didux123/veilleuse-dexcom/firmware/README.md

# Firmware veilleuse — ESP8266 (Wemos D1 mini)

PlatformIO, framework Arduino. Tout le comportement est dans
[`src/main.cpp`](src/main.cpp) ; l'interface de configuration est la page
[`web/veilleuse-config.html`](web/veilleuse-config.html).

## Câblage

```
Ruban SK6812/WS2812B          Wemos D1 mini
   5V  ──────────────────────  5V
   GND ──────────────────────  G
   DIN ──────────────────────  D1 (GPIO5)
```

- 12 LED (`NUM_LEDS`), ruban 60 LED/m collé en anneau dans le boîtier.
- Optionnel mais recommandé : ~330 Ω en série sur DIN, condensateur
  470–1000 µF entre 5V et GND.
- Consommation max réelle ≈ 0,3 A (rouge pur ×12) : n'importe quel
  chargeur USB correct suffit.

## Configuration : rien à compiler

**Aucun identifiant n'est compilé dans le binaire.** Au premier démarrage (ou
si le WiFi est inconnu), la lampe émet le réseau **ouvert** `Veilleuse-XXXX` :
on s'y connecte depuis un téléphone et **la page s'ouvre toute seule**, comme
un portail WiFi d'hôtel. Un seul formulaire regroupe :

| Champ | Rôle |
|---|---|
| Réseau WiFi + mot de passe | Connexion (jusqu'à 10 réseaux mémorisés) |
| Email + mot de passe Dexcom | Compte **publieur** (app G7, partage actif) |
| Région | Europe (`shareous1`) ou US (`share2`) |
| Seuils hypo / hyper / gyrophare | mg/dL, validés `40 ≤ hypo < hyper < gyrophare ≤ 400` |
| Mode nuit : début, fin, luminosité | Horaires **HH:MM** et % (5-100) |
| Mises à jour automatiques | Activables / désactivables |

Les champs de mot de passe laissés vides ne modifient rien (pratique pour ne
changer qu'un seuil). Tout est persisté dans `/config.cfg` en flash.

**La même page reste accessible en permanence** sur le réseau local à
`http://veilleuse-xxxxxx.local/` : c'est là qu'on revient pour modifier les
réglages. L'adresse est affichée à la fin du parcours d'installation.

Pour le développement, `include/secrets.h` (copié depuis `secrets.h.example`)
permet de pré-remplir WiFi et compte Dexcom. La config du portail est toujours
prioritaire sur `secrets.h`.

## Identité unique

Chaque lampe dérive son identité de sa puce (`ESP.getChipId()`) : hostname
mDNS/OTA `veilleuse-xxxxxx`, SSID de portail `Veilleuse-XXXX`. Plusieurs lampes
cohabitent sans collision. Visible dans `GET /api/diag` ou en série au boot :

```
[id] chipid 5FB874 | hostname veilleuse-5fb874 | AP Veilleuse-B874 | fw 1.2.0
```

## Endpoints HTTP

| Endpoint | Rôle |
|---|---|
| `GET /` | La page (gzip depuis PROGMEM, ~6 Ko) |
| `GET /api/status` | `state`, `label`, `mgdl`, `trend`, `age`, `fw`, `host` |
| `GET /api/config` | Réglages courants — **jamais de mot de passe** |
| `GET /api/scan` | Réseaux vus (cache ; relance un scan en fond) |
| `POST /api/save` | Enregistre (x-www-form-urlencoded) puis redémarre |
| `POST /api/forget` | Réinitialisation : efface WiFi, compte Dexcom et réglages, puis redémarre |
| `GET /api/diag` | Heap, uptime, `lps`, WiFi, état — diagnostic |
| `GET /api/log` | Les ~1000 derniers caractères du journal |
| `GET /api/portal?on=1` | Force l'ouverture du portail (test sans couper le WiFi) |

`state` ∈ `ok|hi|hs|lo|un|su|bo|er`, calqué sur les états LED.
Les sondes de détection captive (`/generate_204`, `/hotspot-detect.html`,
`/ncsi.txt`…) renvoient un 302 vers l'IP du point d'accès quand le portail est
ouvert : c'est ce qui déclenche l'ouverture automatique de la page.

## Flasher

```bash
pio run -t upload                                                      # USB
pio run -e d1_mini_ota -t upload --upload-port veilleuse-xxxxxx.local    # WiFi
```

Le port série est auto-détecté ; l'OTA accepte aussi une adresse IP. Pendant un
flash, l'anneau affiche une barre bleue. **Une fenêtre OTA de 3 s est garantie à
chaque démarrage**, avant l'initialisation du serveur web : si un firmware
défectueux est publié, il reste ce créneau pour reflasher sans démonter la lampe.

## La page web

`web/veilleuse-config.html` est la source éditable (17 Ko). Avant chaque
compilation, `tools/gen_web.py` (pre-script PlatformIO) la gzippe et génère
`include/web_page.h` (~6 Ko en PROGMEM, non versionné). Éditer la page suffit,
le build s'occupe du reste.

Pour itérer sur le design sans flasher : servir la page depuis un petit serveur
local qui renvoie des JSON figés sur les 4 endpoints.

## Mises à jour automatiques

Chaque lampe consulte les [GitHub Releases](https://github.com/didux123/veilleuse-dexcom/releases)
du projet et s'installe la nouvelle version toute seule :

- **Quand** : dès le premier relevé réussi après le démarrage — et si la
  vérification est reportée (page consultée, alerte en cours, RAM basse) elle
  est retentée à chaque relevé suivant. En pratique une lampe récupère une
  nouvelle version **une à deux minutes après son démarrage** (mesuré). Le
  rendez-vous quotidien vers 4 h (minute = `chipid % 60`, ce qui étale les
  téléchargements d'un parc) ne sert donc qu'aux lampes allumées depuis
  longtemps.
- **Quoi** : n'installe que des versions **strictement plus récentes**
  (comparaison sémantique `X.Y.Z`). ⚠️ Une simple inégalité serait tentante
  pour permettre les retours en arrière, mais elle **rétrograde** toute lampe
  portant un firmware plus récent que la release publiée — mesuré en vrai :
  une lampe en 1.2.0 s'est réinstallé la 1.1.0 publiée, perdant son serveur
  web. Pour revenir en arrière, **republier l'ancien code sous un numéro plus
  haut**.
- **Garde-fous** : désactivable depuis la page ; jamais pendant une hypo ou un
  gyrophare ; jamais si quelqu'un consulte la page (moins de 60 s) ou est
  connecté au portail ; pas si la RAM libre est insuffisante ; une version qui
  échoue est retentée 3 fois au maximum (suivi dans `/update.txt`).

Chaque lampe publie aussi sa version en mDNS :
`dns-sd -L veilleuse-xxxxxx _arduino._tcp local` affiche `fw=1.2.0`.

⚙️ Détail à connaître : `objects.githubusercontent.com` n'annonce pas de
`max_fragment_length` et envoie des enregistrements TLS pleine taille. Le
téléchargement du binaire renvoie **zéro octet** avec un buffer de réception de
1 ou 4 Ko — il faut **16 Ko** (`TLS_RX_BULK`). `version.txt` se contente de 4 Ko.

⚠️ L'ESP8266 n'a pas de partition de secours : un firmware qui ne démarre pas
oblige à un reflash de chaque lampe. D'où l'étape canari du script de release.

## Publier une version
### ⚠️ Les binaires publiés ne doivent contenir aucun identifiant

`include/secrets.h` est compilé **dans** le firmware. Un `firmware.bin` publié
sur un dépôt public est téléchargeable par tout le monde et `strings` suffit à
en extraire l'email, le mot de passe Dexcom et les identifiants WiFi.

`scripts/release.sh` met donc le `secrets.h` du poste de dev de côté, compile
avec des valeurs vides, **vérifie que le binaire ne contient aucune de vos
valeurs** (sinon il refuse de publier) et le restaure ensuite. Ne jamais
publier un binaire compilé à la main sans cette vérification :

```bash
strings firmware/.pio/build/d1_mini/firmware.bin | grep -i votre-email
```

```bash
./scripts/release.sh
```

Le script refuse un arbre git sale, un HEAD non poussé ou un tag existant ;
il compile, génère `version.txt`, **impose de valider la version sur sa propre
lampe** (canari) puis publie la release. Incrémenter `FW_VERSION` dans
`main.cpp` avant de le lancer.

Pour tester la chaîne d'auto-update sans exposer le parc : publier une
**prerelease** (invisible de `latest`) et flasher une lampe de test avec
l'environnement `d1_mini_testupd`.

## Vérification des identifiants Dexcom

Une faute de frappe dans le mot de passe Dexcom doit se voir **tout de suite**,
pas après un redémarrage. Deux situations :

- **La lampe a déjà du réseau** (page de réglages) : `POST /api/save` teste le
  couple email/mot de passe auprès de Dexcom *avant* d'enregistrer (~1,5 s) et
  répond `400 {"err":"dexcom"}` en cas de refus. Rien n'est écrit, rien ne
  redémarre, la page ramène l'utilisateur sur l'écran du compte.
- **Première configuration par le portail captif** : la lampe n'a aucun accès
  Internet, elle ne peut rien vérifier. Elle **n'redémarre donc pas** — un
  reboot ferait disparaître son réseau 15 s, le téléphone partirait voir
  ailleurs et l'utilisateur n'apprendrait jamais son erreur. À la place elle
  répond `{"ok":true,"pending":true}`, garde son point d'accès et se connecte
  au WiFi à chaud ; la page interroge `/api/status` toutes les 3 s et affiche
  le verdict réel (`wifi` et `pending` sont là pour ça) : « Connexion au
  WiFi… », « Réseau introuvable ou mot de passe incorrect », « Identifiants
  Dexcom refusés », ou la glycémie. Ce n'est qu'une fois la réussite constatée
  que la lampe redémarre, 10 s plus tard — le temps de laisser lire l'adresse.

Un seul essai d'authentification par action humaine, dans tous les cas : la
règle anti-verrouillage du compte Dexcom n'est pas assouplie. Et si les
identifiants n'ont pas changé, aucune vérification n'est envoyée.

## Emmener la lampe ailleurs (portail sans réseau connu)

Cas réel : une lampe configurée à la maison, emmenée chez quelqu'un d'autre.
Le réseau habituel est absent, la lampe passe bien en violet — mais **son
point d'accès restait introuvable**, donc impossible de la reconfigurer.

Cause : l'ESP8266 n'a **qu'une seule radio**. Avec `setAutoReconnect(true)` et
des identifiants mémorisés, la station cherche son réseau habituel en
permanence, en balayant les canaux ; pendant ce temps le point d'accès
n'émet plus ses balises et n'apparaît dans aucun téléphone.

Correctif : quand le portail s'ouvre **faute de réseau**, la radio lui est
**dédiée** — `setAutoReconnect(false)`, `WiFi.disconnect(false, false)` puis
`WiFi.mode(WIFI_AP)`, sur un canal fixe (le canal du lieu précédent n'a plus
de sens). ⚠️ La surcharge à un seul argument `WiFi.disconnect(false)` **efface
les identifiants mémorisés** : il faut impérativement la forme à deux
arguments.

Comme la lampe ne cherche alors plus rien, `staRetryTick()` lui ménage une
**fenêtre de recherche de 15 s toutes les 3 minutes**, jamais pendant que
quelqu'un est connecté au portail. Le scan y est **asynchrone** puis suivi
d'un `WiFi.begin()` ciblé : rien ne fige, contrairement à `wifiMulti.run()`.
Un scan réactive toujours la station (le SDK force `enableSTA`) — `pollScan()`
la recoupe donc aussitôt en radio dédiée.

Quand la lampe a du réseau (identifiants Dexcom à corriger), le portail garde
au contraire la station : la page reste jointe sur le réseau local.

Mesuré après correctif, avec un réseau connu mais absent : point d'accès
visible sur **12 relevés consécutifs en 4 min 40**, toujours sur son canal,
fenêtres de recherche comprises.

## Porte de secours : trois coupures

**Débrancher et rebrancher trois fois de suite** (moins de 8 s entre chaque)
force l'ouverture du portail pendant 10 minutes, quel que soit l'état de la
lampe. C'est le dernier recours quand elle est chez quelqu'un d'autre et
refuse de se montrer. Le compteur est dans `/boot.cnt` et se remet à zéro dès
que la lampe tourne plus de 8 secondes : un redémarrage isolé ne déclenche
rien.

## Réinitialisation

Le bouton « Réinitialiser la lampe… » de la page (section Maintenance) demande
une **seconde confirmation** avant d'agir, puis appelle `POST /api/forget` :
`/wifis.txt` et `/update.txt` sont supprimés, une configuration **vide** est
écrite (et non pas le fichier supprimé — son absence ferait retomber sur les
identifiants de `secrets.h`), et le réseau mémorisé par le SDK est oublié juste
avant le redémarrage. La lampe repart en portail, comme sortie de boîte.

L'endpoint n'accepte que `POST` : on ne peut pas effacer une lampe en cliquant
sur un lien. Et la réponse `200` est envoyée **avant** de toucher au WiFi —
couper la STA plus tôt empêcherait la réponse d'arriver et la page annoncerait
un échec alors que l'effacement a réussi.

⚠️ Sur un build de développement, `secrets.h` réintroduit son WiFi au
redémarrage (le seed) : la lampe se reconnecte donc au réseau, mais sans
identifiants Dexcom. Sur un binaire de production (secrets vides) l'oubli est
total.

## Fichiers en flash (LittleFS)

| Fichier | Contenu |
|---|---|
| `/wifis.txt` | Réseaux connus, `ssid<TAB>motdepasse`, plus récent en tête |
| `/config.cfg` | `ver=2`, identifiants, région, seuils, mode nuit (minutes), `ota` |
| `/update.txt` | Dernière version tentée + nombre d'essais (anti-boucle) |

Le format v1 (horaires de nuit en heures entières) est migré automatiquement
vers v2 (minutes) au premier démarrage.

## États lumineux

Voir le [README principal](../README.md#code-couleur). Logique dans
`currentState()` + `render()` : priorité aux erreurs (jamais de faux vert),
hypo à pleine puissance même en mode nuit. `DEMO_MODE 1` en tête de
`main.cpp` fait défiler tous les états (6 s chacun) sans appeler Dexcom.

**Violet/rouge alterné** : identifiants Dexcom refusés ou absents. La lampe
ouvre son portail pour permettre la correction sans reflash, et n'envoie plus
aucune requête à Dexcom tant que de nouveaux identifiants n'ont pas été
enregistrés : une action humaine = un essai (protège le compte d'un
verrouillage).

## Anti-verrouillage Dexcom

Le compte peut être bloqué par des authentifications en rafale. Le firmware
garde `accountId` et la session en RAM, re-login **une seule fois** sur session
expirée, backoff exponentiel 60 s → 5 min sur erreur réseau, et arrêt complet
des requêtes sur identifiants refusés. Ne pas « améliorer » ça avec des
retries agressifs.

## Ordonnancement (à ne pas casser)

`server.handleClient()` et `dns.processNextRequest()` sont **en tête de
`loop()`**. Les opérations bloquantes restantes sont encadrées de garde-fous :
requête TLS Dexcom (2-6 s, différée si quelqu'un consulte la page ou si un scan
tourne), `wifiMulti.run()` (≤ 8 s, jamais si un client est sur le portail),
téléchargement d'une mise à jour (30-60 s, serveur et AP fermés le temps du
flash). Le scan WiFi est **asynchrone** — un scan synchrone appelle
`esp_suspend()` et figerait la boucle, donc les LED et le serveur web.
`GET /api/diag` expose `lps` (itérations de `loop()` par seconde, ~12 000 en
régime normal) : une chute signale un gel.
