didux123/veilleuse-dexcom/landing/design-source/Halo - Landing.dc.html

Veilleuse connectée · Dexcom G6 / G7

# Sa glycémie, en lumière, toute la nuit.

Halo est un galet lumineux posé sur la table de nuit. Il change de couleur et de rythme au fil de la nuit, et c'est tout. Pas d'écran, pas de chiffre, pas de notification à décoder à 3 h du matin.

Précommander Halo Voir la démo

Pensé pour

Les parents d'enfants T1 La chambre d'à côté, sans y entrer.

Les conjoints qui dorment mal Un œil ouvert suffit, le téléphone reste posé.

Les colocs, les grands-parents, les internats Rien à installer, rien à apprendre.

La démo · huit états

## Appuie, et regarde la chambre changer.

Quatre couleurs pour la nuit, quatre pour la mise en route. Chaque état a son rythme : c'est le mouvement qui se remarque, pas la teinte.

BasDans la plage Haut Très haut Sans données Configuration Identifiants refusés Démarrage

{{ demoTitle }}

{{ demoMeta }}

{{ demoText }}

Comment ça marche

## Trois minutes, une main, aucune application.

1

Elle respire en violet

Branche-la : elle ouvre son propre réseau WiFi. Tu t'y connectes, une page s'affiche toute seule.

2

Tu donnes le WiFi et le compte Share

Les identifiants Dexcom Share du porteur, tes seuils, ta plage de nuit. Tout reste dans la lampe.

3

Elle veille

Elle lit la valeur toutes les 60 secondes et se contente d'exister. Plus rien à faire jusqu'à la prochaine panne de courant.

Mode nuit

### 22 % de luminosité entre 22 h et 7 h

Assez pour lire la couleur depuis le lit, pas assez pour éclairer la pièce. Une seule exception, jamais négociable : l'hypo passe à pleine puissance.

Vie privée

### Aucun serveur, aucun compte à créer

La lampe parle directement à Dexcom Share. Nous n'avons pas de cloud, pas de base de données, rien à revendre — il n'y a personne entre elle et toi.

Ce que Halo ne fait pas

· aucune courbe, aucun graphique, aucun chiffre · aucune notification sur ton téléphone · aucun historique, aucune statistique · aucune décision à ta place

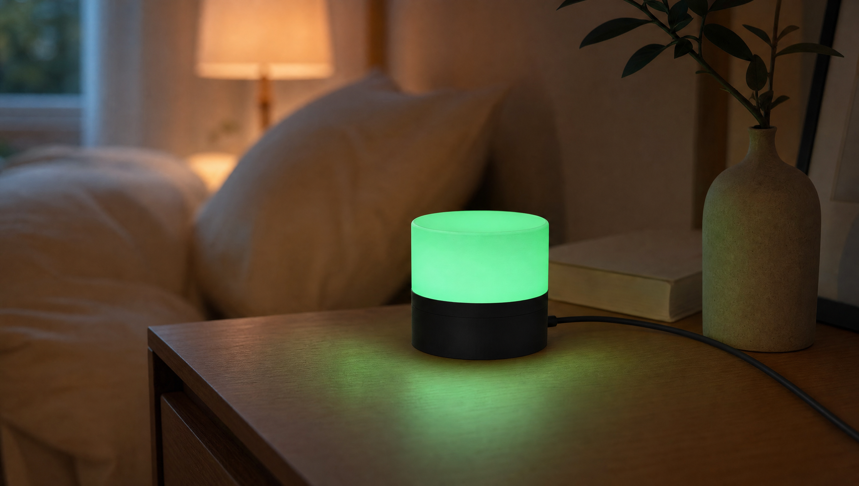
[picture p2: landing/design-source/hero-shot-ms7axl28-aewl.png]
hero-shot


Pourquoi une lampe

« Je me réveillais six fois par nuit pour attraper mon téléphone, déverrouiller, lire un chiffre. Maintenant j'ouvre un œil. »

Le besoin de départ — un objet-compagnon, pas un moniteur de santé.

L'objet

## Un galet de 80 mm, et rien d'autre à installer.

Corps noir mat, dôme blanc translucide, un seul câble qui part vers l'arrière. Elle arrive prête : tu la branches, tu donnes le WiFi, elle veille.

Dans la boîte

· la veilleuse Halo

· alimentation USB-C

· câble tressé 2 m

· guide de mise en route, 1 page

aucune application à installer

Fabriquée en petite série

Coques imprimées et assemblées à l'unité en France. Chaque lampe est testée une nuit entière avant d'être expédiée.

Garantie 2 ans, mises à jour à vie

Active les mises à jour automatiques à la configuration : le firmware se met à jour tout seul, sans rien te demander. Une pièce casse, on te la remplace.

Est-ce un dispositif médical ?

Non. Halo est un objet lumineux de confort. Aucune décision de traitement ne doit être prise à partir de sa couleur — le lecteur et l'app officielle restent la référence.

Et si le WiFi tombe ?

La lampe passe au blanc au bout de quelques minutes sans données fraîches. Elle ne prétend jamais que tout va bien.

Ça marche avec quels capteurs ?

Dexcom G6 et G7 via Share, comptes Europe et US. Un porteur, une lampe — ou plusieurs lampes pour le même porteur.

Je peux changer les seuils ?

Oui, hypo / hyper / gyrophare se règlent au chiffre exact depuis la page de configuration, en mg/dL comme en mmol/L.

Combien consomme-t-elle ?

Moins de 1 W en veille verte nocturne. Elle reste branchée en permanence, comme une veilleuse classique.

## Rends-lui ses nuits.

Première série limitée, livrée configurée. Expédition sous 15 jours.

Précommander Halo Poser une question

halo Halo n'est pas un dispositif médical et n'est affilié ni à Dexcom ni à aucun fabricant de capteurs. En cas de doute, réfère-toi toujours à ton lecteur.
