didux123/veilleuse-dexcom/landing/design-source/Veilleuse Dexcom - DA.dc.html

Direction artistique · v1 / objet + page embarquée

# Une veilleuse qui dit la glycémie en couleur, pas en chiffres.

Cylindre Ø80 × 72 mm, PLA noir mat + dôme blanc translucide, 12 LED RGB, ESP8266. Un galet posé sur une table de nuit — objet‑compagnon, pas moniteur de santé. Cette page pose la DA : les 8 états lumineux, les tokens, le kit, la page de config et une piste vitrine.

1 fichier HTML ~20 Ko en PROGMEM 0 requête externe mobile · nuit d'abord

## 01 — Les huit états

Le SVG est unique ; seules la couleur et le mouvement changent.

Pourquoi : la gravité passe par le mouvement autant que par la teinte — fixe = calme, respiration = attente, rotation = alerte, pulsation = urgence. Un dormeur à moitié réveillé lit un rythme avant de lire une couleur.

Dans la plage

LED 0,36,5 · fixe · écran #45E07F

Tout va bien. Lumière immobile : rien à faire, rien à regarder.

Hyper > 180

LED 66,18,0 · fixe · écran #FFA23A

À surveiller. Même immobilité que le vert : on informe, on ne réveille pas.

Hyper sévère > 300

LED 140,38,0 · bloc de 6 qui tourne · 1,6 s

Gyrophare. On ajoute du mouvement, pas de la lumière : la chambre ne s'éclaire pas davantage.

HYPO < 70

LED 255,0,0 · pulsation 0→255 en 1,2 s · pleine puissance

Urgence. Le dôme rond ne change pas — ce sont les coussins qui disparaissent : contraste au maximum, halo hors cadre, label en bloc plein, angles nets.

On ne sait pas

LED 30,30,30 · fixe · données périmées / réseau coupé

Blanc, jamais vert. Un silence ne doit pas ressembler à un « tout va bien ».

Mode configuration

LED 6,0,9 → 44,0,56 · respiration 3 s

L'objet attend. Le violet est hors du langage glycémie : impossible de le confondre avec une mesure.

Identifiants refusés

violet ⇄ rouge · 600 ms · sans fondu

Erreur à corriger au portail. Alternance dure, jamais de fondu : c'est une panne, pas une mesure.

Démarrage / mise à jour

LED 0,0,28 · point qui tourne, puis barre

Progression. Le bleu n'existe nulle part ailleurs : c'est la couleur de la machine, pas du corps.

La bascule cartoon → alerte, sans changer d'univers

Le vocabulaire reste identique — même galet, mêmes contours épais, mêmes rondeurs. Ce qui change en hypo, ce sont les amortisseurs : le halo diffus devient une pulsation qui sort du cadre, le contraste passe de doux à maximal, l'étiquette abandonne la pastille discrète pour un bloc plein rouge, et le rythme de 1,2 s est deux fois plus rapide que tout le reste de la DA. Résultat : rien de « mignon » n'adoucit le signal, et pourtant on est toujours dans le même monde graphique.

## 02 — Tokens

Teintes dérivées des RGB réels des LED, remontées en luminosité écran.

Pourquoi : la teinte est la source de vérité, la luminosité est un problème de média. On garde le hue du firmware et on remonte L et C pour rester lisible et accessible sur écran.

--v-ok

#45E07F
← 0,36,5

--v-high

#FFA23A
← 66,18,0

--v-high-sev

#FF6B1F
← 140,38,0

--v-low

#FF1F33
← 255,0,0

--v-unknown

#F4F1EA
← 30,30,30

--v-setup

#B96BFF
← 44,0,56

--v-boot

#4C8CFF
← 0,0,28

surfaces

900 → 600
+ --v-line

:root{
/* états — hue du firmware, L/C écran */
--v-ok:#45E07F; --v-high:#FFA23A;
--v-high-sev:#FF6B1F; --v-low:#FF1F33;
--v-unknown:#F4F1EA; --v-setup:#B96BFF;
--v-boot:#4C8CFF;
/* surfaces & encre */
--v-900:#0B0C10; --v-800:#14161D;
--v-700:#1F232D; --v-600:#2A2F3B;
--v-line:#2A2F3B; --v-stroke:#07080B;
--v-ink:#EDEAE3; --v-ink-2:#B9BFCC;
--v-ink-3:#6F7788;
/* type — stack système, 0 Ko */
--v-sans:system-ui,-apple-system,
  "Segoe UI",Roboto,Helvetica,sans-serif;
--v-mono:ui-monospace,SFMono-Regular,
  Menlo,Consolas,monospace;
--t-xs:12px; --t-sm:14px; --t-md:16px;
--t-lg:19px; --t-xl:26px; --t-2xl:34px;
/* rayons — pleins, jamais pointus */
--r-sm:10px; --r-md:16px;
--r-lg:22px; --r-pill:999px;
/* ombres colorées, jamais grises */
--sh-soft:0 14px 30px -18px
  color-mix(in oklab,var(--v-ok) 60%,#000);
--sh-alert:0 18px 40px -16px
  color-mix(in oklab,var(--v-low) 70%,#000);
/* durées = sémantique */
--d-tap:140ms; --d-calm:240ms;
--d-breathe:3s; --d-spin:1.6s;
--d-urgent:1.2s; --d-reject:600ms;
--e-pop:cubic-bezier(.34,1.56,.64,1);
--e-calm:cubic-bezier(.4,0,.2,1);
}

Échelle typo · stack système

Titre 34 / 800

Sous‑titre 26 / 700

Libellé de champ 19 / 600

Corps 16 / 400 — la taille minimale d'un champ tapé d'une main, le soir, à 40 cm.

Mono 12 · valeurs & états

Pourquoi deux familles seulement : la mono porte tout ce qui est chiffre, seuil ou code réseau — l'œil sait où chercher une valeur. Et une stack système coûte 0 Ko sur les 20 Ko.

Rayons & ombres

10

16

22

pill

--sh-soft

--sh-alert

Pourquoi : les ombres sont teintées de l'état, jamais grises — c'est ce qui garde le registre « lumière dans une chambre » au lieu de « carte d'interface ».

## 03 — Kit de composants

Cibles ≥ 52 px, contours 3 px, tout en CSS pur.

Champ texte · mot de passe

Email Dexcom Mot de passe VOIR

Steppers · seuils mg/dL

Hyporouge pulsé − 70 +

Hyperorange fixe − 180 +

Gyropharebloc tournant − 300 +

Pourquoi un stepper et pas un slider : on règle un seuil médical au chiffre exact, à moitié endormi. Le « + » porte la couleur de l'état qu'il gouverne.

Bascule région · segmenté

Europe US

Mode nuit · plage horaire

22:00 07:00

Luminosité réduite 22 %

Liste réseaux · force de signal

Freebox‑Marion ✓

Freebox‑invités WPA2

Livebox‑8A21 faible

Pourquoi des barres et pas une icône : 4 rectangles pèsent 0,1 Ko en HTML pur, aucune police d'icônes, aucune requête.

Bouton principal · secondaire

Enregistrer et redémarrer Rescanner les réseaux

Aucune donnée depuis 14 minbandeau d'état · blanc = on ne sait pas

Hypo en cours · 62 mg/dL ↓bandeau d'alerte · même bloc, tout le contraste

✓ Réglages enregistrés — la veilleuse redémarre

## 04 — Page de config

Portail captif → WiFi → compte Dexcom → réglages → confirmation.

Pourquoi une seule page qui défile plutôt qu'un assistant multi‑écrans : un seul document HTML, zéro routage, zéro JS de navigation — la contrainte des 20 Ko produit ici la bonne UX mobile.

1 · Portail captif

22:41Veilleuse‑A1B2

### Bonsoir. On la met en route ?

La veilleuse respire en violet : elle attend ses réglages. Trois minutes, une main.

Commencer

hors ligne · aucune donnée ne sort d'ici

2 · Réseau WiFi

En attente de configuration fw 1.4.2

### Choisis ton réseau

Freebox‑Marion

Livebox‑8A21

VOIR Se connecter Rescanner

3 · Compte Dexcom

WiFi connecté ‑48 dBm

### Compte publieur

Les identifiants Dexcom Share du porteur. Ils restent dans la veilleuse.

Email Mot de passe

Région du compte

Europe US

Si la lampe clignote violet/rouge, les identifiants sont refusés.

4 · Seuils & nuit

Dernière valeuril y a 40 s 118 →

### Seuils (mg/dL)

Hypo − 70 +

Hyper − 180 +

Gyrophare − 300 +

### Mode nuit

22:00 07:00

Luminosité réduite 22 %

L'hypo ignore le mode nuit : à 22 % elle réveillerait personne.

Enregistrer

5 · Confirmation

### Elle veille.

Vert : 118 mg/dL, stable. Prochaine lecture dans 60 s.

adresseveilleuse‑a1b2c3.local

firmware1.4.2

seuils70 / 180 / 300

nuit22:00 → 07:00 · 22 %

Mise à jour

✓ Réglages enregistrés

## 05 — Piste vitrine

Mêmes tokens, échelle desktop : la DA tient‑elle en grand ?

Veilleuse

## Sa glycémie, en lumière, toute la nuit.

Un galet posé sur la table de nuit. Vert : dors. Orange : demain on regarde. Rouge qui pulse : lève‑toi. Pas d'écran, pas de chiffre, pas de notification.

Voir comment ça marche Imprimer la sienne

Dexcom G7 · Sharelecture 60 sESP8266 · 12 LEDØ80 × 72 mm

Pourquoi ça tient en grand : le hero n'ajoute aucun ingrédient — même galet, mêmes contours, mêmes ombres colorées, juste plus d'air et une typo plus grande. Le seul dégradé autorisé est un halo de couleur d'état, jamais un dégradé décoratif.

06 — Budget 20 Ko

La contrainte fait l'esthétique : pas de police à charger, donc une stack système assumée ; pas d'icônes, donc des formes géométriques ; pas de framework, donc des animations CSS et un SVG unique réutilisé partout.

tokens CSS0,9 Ko

SVG lampe (1×)1,1 Ko

keyframes0,6 Ko

kit + page~11 Ko

JS (scan, submit)~2 Ko

marge~4 Ko

Règles à ne pas casser · Blanc pour « on ne sait pas », jamais vert. · L'hypo ne se réduit ni en luminosité ni en durée. · Une seule couleur pleine à la fois sur le dôme. · Le mouvement dit la gravité, la couleur dit l'état. · Aucun graphique, aucune courbe, aucune jauge.
