didux123/veilleuse-dexcom/hardware/veilleuse_bambulab.3mf

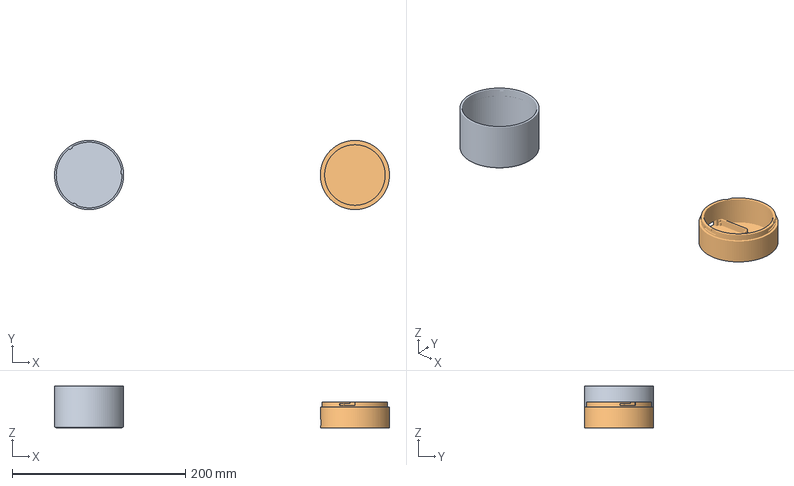
[picture p3: CAD file, 2026-07-26]
hardware/veilleuse_bambulab.3mf
387.2 x 80.0 x 48.0 mm
Diffuseur
veilleuse_base.stl
