didux123/veilleuse-dexcom/hardware/veilleuse_diffuseur.stl

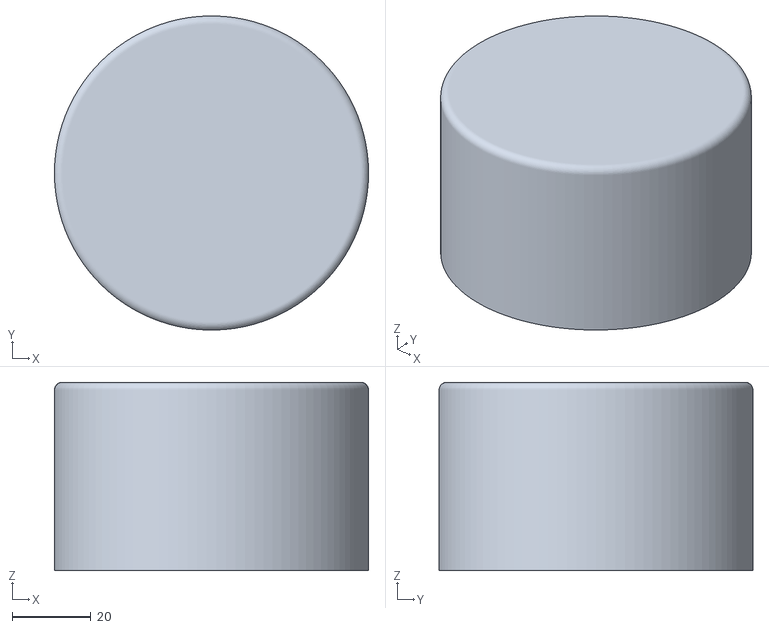
[picture p4: CAD file, 2026-07-26]
hardware/veilleuse_diffuseur.stl
80.0 x 80.0 x 48.0
