didux123/veilleuse-dexcom/hardware/veilleuse_base.stl

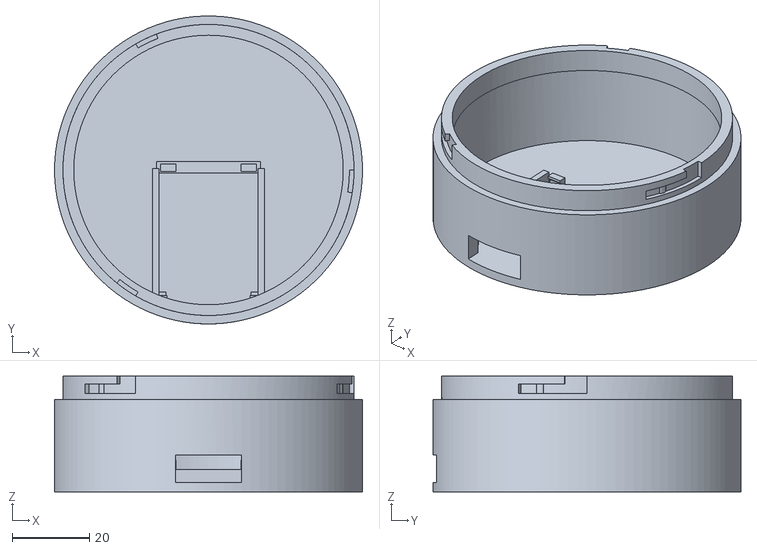
[picture p5: CAD file, 2026-07-26]
hardware/veilleuse_base.stl
80.0 x 80.0 x 30.0
