didux123/veilleuse-dexcom/(list of files, cad)

Other CAD files:
hardware/veilleuse_dexcom.f3d
