didux123/veilleuse-dexcom/(commit log)

2026-07-25 Doc : CONTEXT.md — contexte complet (API, veilleuse ESP, modélisation 3D)
    Ajoute un document de référence unique regroupant la vision du projet,
    le détail de l'API Dexcom Share, le récap du serveur web, le plan de la
    veilleuse ESP8266 standalone, et les pistes de modélisation 3D du boîtier
    diffuseur. Lien ajouté depuis le README.
2026-07-26 Veilleuse complète : firmware ESP8266, boîtier 3D, doc
    - firmware/ : auth Dexcom Share directe, poll 60s anti-lock, portail captif
    WiFi multi-réseaux (LittleFS), mode nuit (TZ Paris), OTA (veilleuse.local),
    états lumineux (hypo pulsée pleine puissance)
    - hardware/ : STL base (berceau à clips mesuré sur F3D du D1 mini) +
    diffuseur baïonnette aminci, projet Bambu Studio, scripts Fusion 360
    paramétriques rejouables, doc de montage
    - README projet + firmware, licence MIT, photo du montage fini
    [veilleuse_bambulab.3mf, veilleuse_base.stl, veilleuse_dexcom.f3d, veilleuse_diffuseur.stl]
2026-07-26 main = veilleuse uniquement ; le dashboard web vit sur la branche web-dashboard
2026-07-26 États stale/erreur : blanc doux fixe au lieu du clignotement bleu/blanc
    Une coupure réseau la nuit ne fait plus clignoter la lampe.
    Blanc = pas de données fiables.
    [main.cpp]
2026-07-27 Gyrophare orange au-dessus de 300 mg/dL (hyper sévère)
    6 LED uniformes en rotation (1 tour/1,5 s) : le mouvement alerte
    sans augmenter la lumière. Seuil HYPER2_MGDL réglable.
2026-07-29 Firmware 1.1.0 : provisioning par portail, identité unique, auto-update
    - Identité par chipid : hostname veilleuse-xxxxxx, AP Veilleuse-XXXX
    (plusieurs lampes cohabitent sans collision OTA/mDNS)
    - Config complète en LittleFS (/config.cfg) : compte Dexcom, région
    US/Europe, seuils hypo/hyper/gyrophare, mode nuit — saisis dans le
    portail captif, plus rien à compiler. secrets.h = dev uniquement.
    - Identifiants refusés : le portail s'ouvre pour les corriger (violet/rouge)
    au lieu d'un blocage jusqu'au reflash. Anti-lock préservé : une
    sauvegarde humaine = une seule tentative.
    - Auto-update depuis GitHub Releases (boot + ~4 h du matin, minute étalée
    par chipid) avec garde-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
    [main.cpp]
2026-07-29 Auto-update : buffer TLS 16 Ko (sinon 0 octet), retries bornés, version en mDNS
    Mesuré sur objects.githubusercontent.com : le téléchargement du binaire
    renvoie zéro octet avec un buffer de réception de 1 ou 4 Ko (pas de
    max_fragment_length, enregistrements TLS pleine taille) ; 16 Ko fonctionne.
    version.txt se contente de 4 Ko.
    - /update.txt passe à "<version> <essais>" : un échec réseau passager est
    retenté (3 fois max) au lieu d'être définitif.
    - Le check de démarrage est rejoué au poll suivant s'il a été reporté.
    - Seuil de heap porté à 28 Ko (le buffer 16 Ko doit tenir).
    - La version tourne en TXT mDNS (fw=) : on sait ce que fait chaque lampe
    du réseau sans la dé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
2026-07-29 Doc : suivi des essais de mise à jour, version en mDNS, contrainte TLS 16 Ko
2026-07-29 v1.2.0 : page de configuration embarquée à la place de WiFiManager
    Intègre le parcours livré par le design (web/veilleuse-config.html, gzippée
    en PROGMEM par tools/gen_web.py) et remplace toute l'UI de WiFiManager par un
    serveur maison ESP8266WebServer + DNSServer.
    - Portail captif : réseau ouvert Veilleuse-XXXX + DNS wildcard + sondes des OS
    (/generate_204, /hotspot-detect.html, /ncsi.txt…) -> la page s'ouvre d'elle
    même sur le téléphone, comme un portail d'hôtel.
    - La même page reste servie en permanence sur le réseau local
    (http://veilleuse-xxxxxx.local/) : les réglages sont enfin réaccessibles
    après l'installation, ce qui manquait totalement.
    - 4 endpoints de la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
2026-07-29 SECURITE : release.sh ne doit jamais publier les identifiants du poste de dev
    secrets.h est compile DANS le firmware. Les binaires des releases v1.1.0 et
    v1.2.0 contenaient donc, sur un depot public, l'email et le mot de passe
    Dexcom ainsi que le SSID et le mot de passe WiFi — extractibles avec un
    simple 'strings'.
    release.sh met desormais secrets.h de cote, compile avec des valeurs vides,
    puis VERIFIE litteralement que le binaire ne contient aucune valeur du
    secrets.h local avant de publier (refus sinon), et le restaure ensuite.
    [main.cpp]
2026-07-30 v1.2.2 : reinitialisation depuis la page, copie de l'adresse, sortie de l'onboarding
    Trois demandes issues de l'usage reel :
    - POST /api/forget + bouton "Reinitialiser la lampe..." (section Maintenance)
    avec double confirmation et 5 s d'annulation. Ecrit une config VIDE plutot
    que de supprimer le fichier, sinon l'absence de config ferait retomber sur
    les identifiants de secrets.h. Refuse les GET : pas d'effacement par simple
    lien.
    Bug trouve en testant sur la lampe : WiFi.disconnect() etait appele AVANT
    server.send(), donc la reponse n'arrivait jamais (HTTP 000) et la page
    annoncait un echec alors que tout avait fonctionne. L'oubli du reseau se
    fait desormais juste avant le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
    [main.cpp]
2026-07-30 v1.2.3 : verifier les identifiants Dexcom pendant que l'utilisateur est la
    Une faute de frappe dans le mot de passe Dexcom ne se manifestait qu'apres le
    redemarrage, 12 a 20 s plus tard, par un discret motif violet/rouge — et en
    portail captif le telephone avait souvent deja quitte le reseau de la lampe,
    donc le message n'arrivait jamais.
    - Lampe deja en ligne : dexProbe() teste le couple email/mot de passe avant
    d'enregistrer (mesure : 1,55 s) et renvoie 400 err:dexcom. Rien n'est ecrit,
    pas de redemarrage, la page renvoie sur l'ecran du compte avec le champ vide.
    Aucune verification si les identifiants n'ont pas change.
    - Premiere configuration (portail, aucun reseau) : impossible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
    [main.cpp]
2026-07-31 v1.2.4 : le portail devient utilisable quand la lampe change de lieu
    Bug remonte par l'usage : lampe configuree a la maison, emmenee ailleurs. Elle
    passait bien en violet (portail actif cote logiciel) mais son point d'acces
    restait INTROUVABLE depuis un telephone, donc impossible a reconfigurer.
    Cause : l'ESP8266 n'a qu'une radio. Avec setAutoReconnect(true) et des
    identifiants memorises, la station cherche son reseau habituel en permanence en
    balayant les canaux ; le point d'acces cesse d'emettre ses balises.
    - Portail ouvert FAUTE DE RESEAU -> radio dediee : setAutoReconnect(false),
    disconnect(false, false) et mode(WIFI_AP), sur un canal fixe. Piege evite :
    la surcharge a un argument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
    [main.cpp]
2026-11-02 Landing page « Halo » et direction artistique (depuis la maquette Claude Design)
    Conversion statique des exports .dc.html : plus de React ni de Babel,
    démo des 8 états en JS vanilla, adaptation mobile, image recompressée.
    Les sources d'origine sont dans landing/design-source/.
    Claude-Session: https://claude.ai/code/session_01Gv4nZ8gNKFX59tu1ot96Rb
2026-11-02 Doc : la landing page dans le tableau du README
    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
